EduHolg/IHP__SoC6169/SoC6169-main/netlist/schematic/SoC6169.spice

* ======================================================================
* SoC6169 - reference netlist for the KLayout LVS (IHP SG13CMOS5L)
* Generated by tools/gen_SoC6169_lvs.py
*  - IO: sg13cmos5l_io.cdl (PDK 456dd2d); sub! -> pin 'vsub' (= VSS at the top level)
*  - decaps: sg13cmos5l_stdcell.cdl
*  - core: COMPLETE_PROYECT_FIG_lvs.spice with the 11 ports added
* Cell count taken from the Magic SoC6169_magic.spice: COMPLETE_PROYECT_FIG=1, bondpad_70x70_5L=19, sg13cmos5l_Corner=4, sg13cmos5l_Filler1000=23, sg13cmos5l_Filler200=23, sg13cmos5l_Filler400=11, sg13cmos5l_Filler4000=28, sg13cmos5l_IOPadAnalog=1, sg13cmos5l_IOPadIOVdd=3, sg13cmos5l_IOPadIOVss=2, sg13cmos5l_IOPadIn=7, sg13cmos5l_IOPadOut30mA=1, sg13cmos5l_IOPadVdd=3, sg13cmos5l_IOPadVss=2, sg13cmos5l_decap_4=123, sg13cmos5l_decap_8=3577, sg13cmos5l_fill_1=123, sg13cmos5l_fill_2=104
* ======================================================================

.subckt SoC6169 IOVDD IOVSS VDD VSS analog_PAD clk_PAD input_PAD[0] input_PAD[1] input_PAD[2] input_PAD[3]
+ input_PAD[4] output_PAD rst_n_PAD

* ---- Core CAM 32x32 ----
Xi_chip_core en_write_core en_reference_core en_search_core reset_core clk_core serial_in_addr_core
+ output_core serial_in_data_core veval_in_core VDD VSS COMPLETE_PROYECT_FIG

* ---- Input pads (pad p2c vdd vss iovdd iovss sub) ----
Xinputs_0_pad input_PAD[0] en_write_core VDD VSS IOVDD IOVSS VSS sg13cmos5l_IOPadIn
Xinputs_1_pad input_PAD[1] en_reference_core VDD VSS IOVDD IOVSS VSS sg13cmos5l_IOPadIn
Xinputs_2_pad input_PAD[2] en_search_core VDD VSS IOVDD IOVSS VSS sg13cmos5l_IOPadIn
Xinputs_3_pad input_PAD[3] serial_in_addr_core VDD VSS IOVDD IOVSS VSS sg13cmos5l_IOPadIn
Xinputs_4_pad input_PAD[4] serial_in_data_core VDD VSS IOVDD IOVSS VSS sg13cmos5l_IOPadIn
Xrst_n_pad rst_n_PAD reset_core VDD VSS IOVDD IOVSS VSS sg13cmos5l_IOPadIn
Xclk_pad clk_PAD clk_core VDD VSS IOVDD IOVSS VSS sg13cmos5l_IOPadIn
* ---- Output pad (pad c2p vdd vss iovdd iovss sub) ----
Xoutputs_0_pad output_PAD output_core VDD VSS IOVDD IOVSS VSS sg13cmos5l_IOPadOut30mA
* ---- Analog pad VEVAL_IN (pad padres vdd vss iovdd iovss sub) ----
Xanalogs_0_pad analog_PAD veval_in_core VDD VSS IOVDD IOVSS VSS sg13cmos5l_IOPadAnalog
* ---- Power pads ----
Xvdd_pads_0 VDD VSS IOVDD IOVSS VSS sg13cmos5l_IOPadVdd
Xvdd_pads_1 VDD VSS IOVDD IOVSS VSS sg13cmos5l_IOPadVdd
Xvdd_pads_2 VDD VSS IOVDD IOVSS VSS sg13cmos5l_IOPadVdd
Xvss_pads_0 VDD VSS IOVDD IOVSS VSS sg13cmos5l_IOPadVss
Xvss_pads_1 VDD VSS IOVDD IOVSS VSS sg13cmos5l_IOPadVss
Xiovdd_pads_0 VDD VSS IOVDD IOVSS VSS sg13cmos5l_IOPadIOVdd
Xiovdd_pads_1 VDD VSS IOVDD IOVSS VSS sg13cmos5l_IOPadIOVdd
Xiovdd_pads_2 VDD VSS IOVDD IOVSS VSS sg13cmos5l_IOPadIOVdd
Xiovss_pads_0 VDD VSS IOVDD IOVSS VSS sg13cmos5l_IOPadIOVss
Xiovss_pads_1 VDD VSS IOVDD IOVSS VSS sg13cmos5l_IOPadIOVss
* ---- Pad-ring corners and fillers ----
XCorner_0 VDD VSS IOVDD IOVSS sg13cmos5l_Corner
XCorner_1 VDD VSS IOVDD IOVSS sg13cmos5l_Corner
XCorner_2 VDD VSS IOVDD IOVSS sg13cmos5l_Corner
XCorner_3 VDD VSS IOVDD IOVSS sg13cmos5l_Corner
XFiller4000_0 VDD VSS IOVDD IOVSS sg13cmos5l_Filler4000
XFiller4000_1 VDD VSS IOVDD IOVSS sg13cmos5l_Filler4000
XFiller4000_2 VDD VSS IOVDD IOVSS sg13cmos5l_Filler4000
XFiller4000_3 VDD VSS IOVDD IOVSS sg13cmos5l_Filler4000
XFiller4000_4 VDD VSS IOVDD IOVSS sg13cmos5l_Filler4000
XFiller4000_5 VDD VSS IOVDD IOVSS sg13cmos5l_Filler4000
XFiller4000_6 VDD VSS IOVDD IOVSS sg13cmos5l_Filler4000
XFiller4000_7 VDD VSS IOVDD IOVSS sg13cmos5l_Filler4000
XFiller4000_8 VDD VSS IOVDD IOVSS sg13cmos5l_Filler4000
XFiller4000_9 VDD VSS IOVDD IOVSS sg13cmos5l_Filler4000
XFiller4000_10 VDD VSS IOVDD IOVSS sg13cmos5l_Filler4000
XFiller4000_11 VDD VSS IOVDD IOVSS sg13cmos5l_Filler4000
XFiller4000_12 VDD VSS IOVDD IOVSS sg13cmos5l_Filler4000
XFiller4000_13 VDD VSS IOVDD IOVSS sg13cmos5l_Filler4000
XFiller4000_14 VDD VSS IOVDD IOVSS sg13cmos5l_Filler4000
XFiller4000_15 VDD VSS IOVDD IOVSS sg13cmos5l_Filler4000
XFiller4000_16 VDD VSS IOVDD IOVSS sg13cmos5l_Filler4000
XFiller4000_17 VDD VSS IOVDD IOVSS sg13cmos5l_Filler4000
XFiller4000_18 VDD VSS IOVDD IOVSS sg13cmos5l_Filler4000
XFiller4000_19 VDD VSS IOVDD IOVSS sg13cmos5l_Filler4000
XFiller4000_20 VDD VSS IOVDD IOVSS sg13cmos5l_Filler4000
XFiller4000_21 VDD VSS IOVDD IOVSS sg13cmos5l_Filler4000
XFiller4000_22 VDD VSS IOVDD IOVSS sg13cmos5l_Filler4000
XFiller4000_23 VDD VSS IOVDD IOVSS sg13cmos5l_Filler4000
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
Xdecap_8_546 VDD VSS sg13cmos5l_decap_8
Xdecap_8_547 VDD VSS sg13cmos5l_decap_8
Xdecap_8_548 VDD VSS sg13cmos5l_decap_8
Xdecap_8_549 VDD VSS sg13cmos5l_decap_8
Xdecap_8_550 VDD VSS sg13cmos5l_decap_8
Xdecap_8_551 VDD VSS sg13cmos5l_decap_8
Xdecap_8_552 VDD VSS sg13cmos5l_decap_8
Xdecap_8_553 VDD VSS sg13cmos5l_decap_8
Xdecap_8_554 VDD VSS sg13cmos5l_decap_8
Xdecap_8_555 VDD VSS sg13cmos5l_decap_8
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
