EduHolg/IHP__SoC6169/SoC6169-main/testbenches/spectre/digital_blocks.spice

simulator lang=spice
* Netlists of the 6 digital blocks (CAM_CONTROL, REFERENCE_MUX, decoder_5to32,
* shift_register_32, OUTPUT, SHIFT_5) with their sg13g2 standard cells.
* Taken from SoCXXXX-main/netlist/schematic/COMPLETE_PROYECT_FIG_lvs.spice (the netlist that passes LVS).
* Replaces the 6 includes CAMPROYECT/<block>/spiceText/spice.spc of the original testbench.

**************************************************
* SUBCKT: CAM_CONTROL
**************************************************

.subckt CAM_CONTROL EN_REFERENCE EN_SEARCH EN_WRITE PC VEVAL clk output_enable reset REF_SEL WL_REF
+ addr_shift_enable decoder_enable shift_enable VGND VPWR

Xctl_sg13g2_and2_1_3 ctl_sg13g2_and2_1_3_X VGND VPWR ctl_sg13g2_and2_1_3_B ctl_sg13g2_nor3_1_4_A
+ ctl_sg13g2_and2_1
Xctl_sg13g2_nand2b_1_0 VGND ctl_sg13g2_nor3_1_3_B ctl_sg13g2_nand2_1_4_A ctl_sg13g2_nor2_1_10_B VPWR
+ ctl_sg13g2_nand2b_1
Xctl_sg13g2_inv_1_1 ctl_sg13g2_inv_1_1_Y ctl_sg13g2_inv_1_6_A VGND VPWR ctl_sg13g2_inv_1
Xctl_sg13g2_buf_1_1 decoder_enable ctl_sg13g2_buf_1_1_A VGND VPWR ctl_sg13g2_buf_1
Xctl_sg13g2_dlygate4sd3_1_14 ctl_sg13g2_nor3_1_0_Y VPWR VGND ctl_sg13g2_nor4_1_0_A ctl_sg13g2_dlygate4sd3_1
Xctl_sg13g2_nor2_1_5 ctl_sg13g2_nor2_1_5_A VPWR ctl_sg13g2_nor4_1_0_D VGND ctl_sg13g2_nor3_1_0_A
+ ctl_sg13g2_nor2_1
Xctl_sg13g2_dfrbpq_1_9 clk VGND ctl_sg13g2_nor4_1_0_Y ctl_sg13g2_buf_1_5_A VPWR ctl_sg13g2_inv_1_17_Y
+ ctl_sg13g2_dfrbpq_1
Xctl_sg13g2_and2_1_4 ctl_sg13g2_nor3_1_0_B VGND VPWR ctl_sg13g2_or2_1_0_B ctl_sg13g2_or2_1_0_A
+ ctl_sg13g2_and2_1
Xctl_sg13g2_nand4_1_0 VPWR ctl_sg13g2_nand4_1_0_Y ctl_sg13g2_nor3_1_6_B ctl_sg13g2_nor2_1_2_A VGND
+ ctl_sg13g2_inv_1_0_A ctl_sg13g2_nor3_1_6_C ctl_sg13g2_nand4_1
Xctl_sg13g2_nand2b_1_1 VGND ctl_sg13g2_xor2_1_1_B ctl_sg13g2_nor2_1_10_B ctl_sg13g2_and2_1_2_B VPWR
+ ctl_sg13g2_nand2b_1
Xctl_sg13g2_inv_1_2 ctl_sg13g2_inv_1_2_Y ctl_sg13g2_inv_1_6_A VGND VPWR ctl_sg13g2_inv_1
Xctl_sg13g2_buf_1_2 VEVAL ctl_sg13g2_buf_1_2_A VGND VPWR ctl_sg13g2_buf_1
Xctl_sg13g2_buf_1_10 ctl_sg13g2_buf_1_10_X EN_WRITE VGND VPWR ctl_sg13g2_buf_1
Xctl_sg13g2_nor2_1_6 ctl_sg13g2_nor2_1_7_A VPWR ctl_sg13g2_nor2_1_6_Y VGND ctl_sg13g2_nor3_1_3_B
+ ctl_sg13g2_nor2_1
Xctl_sg13g2_dlygate4sd3_1_15 ctl_sg13g2_or2_1_0_A VPWR VGND ctl_sg13g2_xor2_1_0_A ctl_sg13g2_dlygate4sd3_1
Xctl_sg13g2_nand2b_1_2 VGND ctl_sg13g2_o21ai_1_7_A1 ctl_sg13g2_nand2_1_3_A ctl_sg13g2_buf_1_10_X VPWR
+ ctl_sg13g2_nand2b_1
Xctl_sg13g2_a221oi_1_0 ctl_sg13g2_and2_1_3_X ctl_sg13g2_o21ai_1_4_A2 ctl_sg13g2_nor3_1_1_B
+ ctl_sg13g2_nor3_1_2_A ctl_sg13g2_mux2_1_1_X VPWR ctl_sg13g2_inv_1_27_Y VGND ctl_sg13g2_a221oi_1
Xctl_sg13g2_buf_1_3 shift_enable ctl_sg13g2_buf_1_3_A VGND VPWR ctl_sg13g2_buf_1
Xctl_sg13g2_buf_1_11 REF_SEL ctl_sg13g2_buf_1_11_A VGND VPWR ctl_sg13g2_buf_1
Xctl_sg13g2_inv_1_3 ctl_sg13g2_inv_1_3_Y ctl_sg13g2_inv_1_6_A VGND VPWR ctl_sg13g2_inv_1
Xctl_sg13g2_a21o_1_0 ctl_sg13g2_nor3_1_6_C ctl_sg13g2_a21o_1_0_X VPWR VGND ctl_sg13g2_inv_1_0_A
+ ctl_sg13g2_nor3_1_6_B ctl_sg13g2_a21o_1
Xctl_sg13g2_nor2_1_7 ctl_sg13g2_nor2_1_7_A VPWR ctl_sg13g2_nor3_1_3_C VGND ctl_sg13g2_nor3_1_1_A
+ ctl_sg13g2_nor2_1
Xctl_sg13g2_nand2b_1_3 VGND ctl_sg13g2_a21oi_1_3_B1 ctl_sg13g2_nand2b_1_5_B ctl_sg13g2_buf_1_9_X VPWR
+ ctl_sg13g2_nand2b_1
Xctl_sg13g2_buf_1_4 output_enable ctl_sg13g2_buf_1_4_A VGND VPWR ctl_sg13g2_buf_1
Xctl_sg13g2_buf_1_12 ctl_sg13g2_buf_1_12_X EN_SEARCH VGND VPWR ctl_sg13g2_buf_1
Xctl_sg13g2_inv_1_4 ctl_sg13g2_inv_1_4_Y ctl_sg13g2_inv_1_4_A VGND VPWR ctl_sg13g2_inv_1
Xctl_sg13g2_a21o_1_1 ctl_sg13g2_nor2_1_9_Y ctl_sg13g2_a21o_1_1_X VPWR VGND ctl_sg13g2_a21o_1_1_A1
+ ctl_sg13g2_buf_1_12_X ctl_sg13g2_a21o_1
Xctl_sg13g2_nor2_1_8 ctl_sg13g2_nor2_1_9_Y VPWR ctl_sg13g2_inv_1_0_A VGND ctl_sg13g2_nor2_1_8_B
+ ctl_sg13g2_nor2_1
Xctl_sg13g2_nand2b_1_4 VGND ctl_sg13g2_a21o_1_1_A1 ctl_sg13g2_nand2b_1_4_Y ctl_sg13g2_buf_1_12_X VPWR
+ ctl_sg13g2_nand2b_1
Xctl_sg13g2_buf_1_5 addr_shift_enable ctl_sg13g2_buf_1_5_A VGND VPWR ctl_sg13g2_buf_1
Xctl_sg13g2_inv_1_5 ctl_sg13g2_inv_1_5_Y ctl_sg13g2_inv_1_6_A VGND VPWR ctl_sg13g2_inv_1
Xctl_sg13g2_buf_1_13 ctl_sg13g2_inv_1_6_A ctl_sg13g2_buf_1_8_A VGND VPWR ctl_sg13g2_buf_1
Xctl_sg13g2_a21o_1_2 ctl_sg13g2_nor3_1_0_B ctl_sg13g2_buf_1_15_A VPWR VGND ctl_sg13g2_or2_1_0_X
+ ctl_sg13g2_nor3_1_0_A ctl_sg13g2_a21o_1
Xctl_sg13g2_nor2_1_9 ctl_sg13g2_nor2_1_9_A VPWR ctl_sg13g2_nor2_1_9_Y VGND ctl_sg13g2_nor2_1_9_B
+ ctl_sg13g2_nor2_1
Xctl_sg13g2_nand2b_1_5 VGND ctl_sg13g2_nand2b_1_4_Y ctl_sg13g2_nor2_1_9_B ctl_sg13g2_nand2b_1_5_B VPWR
+ ctl_sg13g2_nand2b_1
Xctl_sg13g2_buf_1_6 ctl_sg13g2_buf_1_7_A reset VGND VPWR ctl_sg13g2_buf_1
Xctl_sg13g2_inv_1_6 ctl_sg13g2_inv_1_6_Y ctl_sg13g2_inv_1_6_A VGND VPWR ctl_sg13g2_inv_1
Xctl_sg13g2_buf_1_14 ctl_sg13g2_xor2_1_1_A ctl_sg13g2_buf_1_14_A VGND VPWR ctl_sg13g2_buf_1
Xctl_sg13g2_a21o_1_3 ctl_sg13g2_and2_1_3_X ctl_sg13g2_or2_1_0_B VPWR VGND ctl_sg13g2_inv_1_27_Y
+ ctl_sg13g2_mux2_1_1_X ctl_sg13g2_a21o_1
Xctl_sg13g2_nand2b_1_6 VGND ctl_sg13g2_xor2_1_1_A ctl_sg13g2_mux2_1_1_A0 ctl_sg13g2_xor2_1_1_B VPWR
+ ctl_sg13g2_nand2b_1
Xctl_sg13g2_buf_1_7 ctl_sg13g2_buf_1_8_A ctl_sg13g2_buf_1_7_A VGND VPWR ctl_sg13g2_buf_1
Xctl_sg13g2_inv_1_7 ctl_sg13g2_inv_1_7_Y ctl_sg13g2_inv_1_9_A VGND VPWR ctl_sg13g2_inv_1
Xctl_sg13g2_buf_1_15 ctl_sg13g2_nor3_1_3_B ctl_sg13g2_buf_1_15_A VGND VPWR ctl_sg13g2_buf_1
Xctl_sg13g2_buf_1_8 ctl_sg13g2_inv_1_9_A ctl_sg13g2_buf_1_8_A VGND VPWR ctl_sg13g2_buf_1
Xctl_sg13g2_buf_1_16 WL_REF ctl_sg13g2_buf_1_16_A VGND VPWR ctl_sg13g2_buf_1
Xctl_sg13g2_inv_1_8 ctl_sg13g2_inv_1_8_Y ctl_sg13g2_inv_1_9_A VGND VPWR ctl_sg13g2_inv_1
Xctl_sg13g2_dlygate4sd3_1_0 ctl_sg13g2_a21oi_1_1_Y VPWR VGND ctl_sg13g2_nor3_1_6_C ctl_sg13g2_dlygate4sd3_1
Xctl_sg13g2_o21ai_1_0 VGND VPWR ctl_sg13g2_o21ai_1_0_Y ctl_sg13g2_buf_1_15_A ctl_sg13g2_buf_1_14_A
+ ctl_sg13g2_nor3_1_4_A ctl_sg13g2_o21ai_1
Xctl_sg13g2_buf_1_9 ctl_sg13g2_buf_1_9_X EN_REFERENCE VGND VPWR ctl_sg13g2_buf_1
Xctl_sg13g2_inv_1_9 ctl_sg13g2_inv_1_9_Y ctl_sg13g2_inv_1_9_A VGND VPWR ctl_sg13g2_inv_1
Xctl_sg13g2_nor2_1_10 ctl_sg13g2_nor3_1_4_Y VPWR ctl_sg13g2_nor2_1_10_Y VGND ctl_sg13g2_nor2_1_10_B
+ ctl_sg13g2_nor2_1
Xctl_sg13g2_dlygate4sd3_1_1 ctl_sg13g2_nor3_1_4_A VPWR VGND ctl_sg13g2_o21ai_1_6_A1 ctl_sg13g2_dlygate4sd3_1
Xctl_sg13g2_o21ai_1_1 VGND VPWR ctl_sg13g2_o21ai_1_1_Y ctl_sg13g2_nor2_1_2_A ctl_sg13g2_nor3_1_5_C
+ ctl_sg13g2_nor3_1_6_C ctl_sg13g2_o21ai_1
Xctl_sg13g2_nor4_1_0 VGND VPWR ctl_sg13g2_nor4_1_0_B ctl_sg13g2_nor4_1_0_C ctl_sg13g2_nor4_1_0_Y
+ ctl_sg13g2_nor4_1_0_A ctl_sg13g2_nor4_1_0_D ctl_sg13g2_nor4_1
Xctl_sg13g2_dlygate4sd3_1_2 ctl_sg13g2_nor3_1_4_B VPWR VGND ctl_sg13g2_a21oi_1_1_A1 ctl_sg13g2_dlygate4sd3_1
Xctl_sg13g2_o21ai_1_2 VGND VPWR ctl_sg13g2_o21ai_1_2_Y ctl_sg13g2_and2_1_3_B ctl_sg13g2_inv_1_25_Y
+ ctl_sg13g2_inv_1_27_Y ctl_sg13g2_o21ai_1
Xctl_sg13g2_dlygate4sd3_1_3 ctl_sg13g2_nand4_1_0_Y VPWR VGND ctl_sg13g2_nor4_1_0_C ctl_sg13g2_dlygate4sd3_1
Xctl_sg13g2_o21ai_1_3 VGND VPWR ctl_sg13g2_o21ai_1_3_Y ctl_sg13g2_nor4_1_0_C ctl_sg13g2_a21o_1_0_X
+ ctl_sg13g2_nor2_1_1_Y ctl_sg13g2_o21ai_1
Xctl_sg13g2_dlygate4sd3_1_4 ctl_sg13g2_dfrbpq_1_17_Q VPWR VGND ctl_sg13g2_nor3_1_1_A ctl_sg13g2_dlygate4sd3_1
Xctl_sg13g2_o21ai_1_4 VGND VPWR ctl_sg13g2_nor3_1_0_A ctl_sg13g2_a21oi_1_2_Y ctl_sg13g2_o21ai_1_4_A2
+ ctl_sg13g2_nor3_1_1_Y ctl_sg13g2_o21ai_1
Xctl_sg13g2_dlygate4sd3_1_5 ctl_sg13g2_dfrbpq_1_8_Q VPWR VGND ctl_sg13g2_nor3_1_1_B ctl_sg13g2_dlygate4sd3_1
Xctl_sg13g2_o21ai_1_5 VGND VPWR ctl_sg13g2_and2_1_2_B ctl_sg13g2_nor3_1_4_B ctl_sg13g2_xor2_1_1_A
+ ctl_sg13g2_nor3_1_4_A ctl_sg13g2_o21ai_1
Xctl_sg13g2_dlygate4sd3_1_6 ctl_sg13g2_dfrbpq_1_11_Q VPWR VGND ctl_sg13g2_nor2_1_7_A ctl_sg13g2_dlygate4sd3_1
Xctl_sg13g2_o21ai_1_6 VGND VPWR ctl_sg13g2_nor2_1_2_A ctl_sg13g2_nand2_1_5_Y ctl_sg13g2_and3_1_1_X
+ ctl_sg13g2_o21ai_1_6_A1 ctl_sg13g2_o21ai_1
Xctl_sg13g2_decap_8_0 VPWR VGND ctl_sg13g2_decap_8
Xctl_sg13g2_or2_1_0 ctl_sg13g2_or2_1_0_A VGND ctl_sg13g2_or2_1_0_B ctl_sg13g2_or2_1_0_X VPWR ctl_sg13g2_or2_1
Xctl_sg13g2_dlygate4sd3_1_7 ctl_sg13g2_dfrbpq_1_10_Q VPWR VGND ctl_sg13g2_nor3_1_1_C ctl_sg13g2_dlygate4sd3_1
Xctl_sg13g2_o21ai_1_7 VGND VPWR ctl_sg13g2_o21ai_1_7_Y ctl_sg13g2_buf_1_10_X ctl_sg13g2_nor2b_1_0_Y
+ ctl_sg13g2_o21ai_1_7_A1 ctl_sg13g2_o21ai_1
Xctl_sg13g2_decap_8_1 VPWR VGND ctl_sg13g2_decap_8
Xctl_sg13g2_dlygate4sd3_1_8 ctl_sg13g2_dfrbpq_1_16_Q VPWR VGND ctl_sg13g2_o21ai_1_7_A1
+ ctl_sg13g2_dlygate4sd3_1
Xctl_sg13g2_a22oi_1_0 ctl_sg13g2_nand2_1_4_B ctl_sg13g2_nor2_1_10_Y VPWR ctl_sg13g2_nand2_1_3_Y
+ ctl_sg13g2_nor3_1_3_B VGND ctl_sg13g2_nor2b_1_0_Y ctl_sg13g2_a22oi_1
Xctl_sg13g2_decap_8_2 VPWR VGND ctl_sg13g2_decap_8
Xctl_sg13g2_dlygate4sd3_1_9 ctl_sg13g2_a21oi_1_3_Y VPWR VGND ctl_sg13g2_nor2b_1_1_A ctl_sg13g2_dlygate4sd3_1
Xctl_sg13g2_decap_8_3 VPWR VGND ctl_sg13g2_decap_8
Xctl_sg13g2_a21oi_1_0 VPWR VGND ctl_sg13g2_nor3_1_6_B ctl_sg13g2_inv_1_0_A ctl_sg13g2_nor2_1_2_A
+ ctl_sg13g2_a21oi_1_0_Y ctl_sg13g2_a21oi_1
Xctl_sg13g2_decap_8_4 VPWR VGND ctl_sg13g2_decap_8
Xctl_sg13g2_a21oi_1_1 VPWR VGND ctl_sg13g2_o21ai_1_0_Y ctl_sg13g2_a21oi_1_1_A1 ctl_sg13g2_a21oi_1_4_Y
+ ctl_sg13g2_a21oi_1_1_Y ctl_sg13g2_a21oi_1
Xctl_sg13g2_decap_8_5 VPWR VGND ctl_sg13g2_decap_8
Xctl_sg13g2_a21oi_1_2 VPWR VGND ctl_sg13g2_mux2_1_1_X ctl_sg13g2_inv_1_27_Y ctl_sg13g2_a21oi_1_5_Y
+ ctl_sg13g2_a21oi_1_2_Y ctl_sg13g2_a21oi_1
Xctl_sg13g2_a21oi_1_3 VPWR VGND ctl_sg13g2_nand2_1_3_A ctl_sg13g2_nor2b_1_0_Y ctl_sg13g2_a21oi_1_3_B1
+ ctl_sg13g2_a21oi_1_3_Y ctl_sg13g2_a21oi_1
Xctl_sg13g2_decap_4_0 VPWR VGND ctl_sg13g2_decap_4
Xctl_sg13g2_nor3_1_0 ctl_sg13g2_nor3_1_0_A ctl_sg13g2_nor3_1_0_Y ctl_sg13g2_nor3_1_0_B ctl_sg13g2_nor3_1_0_C
+ VPWR VGND ctl_sg13g2_nor3_1
Xctl_sg13g2_inv_1_20 ctl_sg13g2_inv_1_20_Y ctl_sg13g2_buf_1_8_A VGND VPWR ctl_sg13g2_inv_1
Xctl_sg13g2_a21oi_1_4 VPWR VGND ctl_sg13g2_nand2b_1_5_B ctl_sg13g2_nand2b_1_4_Y ctl_sg13g2_nor2_1_9_A
+ ctl_sg13g2_a21oi_1_4_Y ctl_sg13g2_a21oi_1
Xctl_sg13g2_nor3_1_1 ctl_sg13g2_nor3_1_1_A ctl_sg13g2_nor3_1_1_Y ctl_sg13g2_nor3_1_1_B ctl_sg13g2_nor3_1_1_C
+ VPWR VGND ctl_sg13g2_nor3_1
Xctl_sg13g2_decap_4_1 VPWR VGND ctl_sg13g2_decap_4
Xctl_sg13g2_inv_1_21 ctl_sg13g2_inv_1_21_Y ctl_sg13g2_inv_1_9_A VGND VPWR ctl_sg13g2_inv_1
Xctl_sg13g2_inv_1_10 ctl_sg13g2_inv_1_10_Y ctl_sg13g2_inv_1_9_A VGND VPWR ctl_sg13g2_inv_1
Xctl_sg13g2_and3_1_0 ctl_sg13g2_and3_1_0_X ctl_sg13g2_nor3_1_6_B VPWR VGND ctl_sg13g2_nor3_1_5_A
+ ctl_sg13g2_inv_1_0_A ctl_sg13g2_and3_1
Xctl_sg13g2_a21oi_1_5 VPWR VGND ctl_sg13g2_xor2_1_1_A ctl_sg13g2_inv_1_25_Y ctl_sg13g2_inv_1_27_Y
+ ctl_sg13g2_a21oi_1_5_Y ctl_sg13g2_a21oi_1
Xctl_sg13g2_decap_4_2 VPWR VGND ctl_sg13g2_decap_4
Xctl_sg13g2_nor3_1_2 ctl_sg13g2_nor3_1_2_A ctl_sg13g2_nor3_1_2_Y ctl_sg13g2_nor3_1_3_B ctl_sg13g2_nor3_1_2_C
+ VPWR VGND ctl_sg13g2_nor3_1
Xctl_sg13g2_inv_1_22 ctl_sg13g2_inv_1_22_Y ctl_sg13g2_inv_1_6_A VGND VPWR ctl_sg13g2_inv_1
Xctl_sg13g2_inv_1_11 ctl_sg13g2_nor3_1_5_B ctl_sg13g2_nor3_1_6_C VGND VPWR ctl_sg13g2_inv_1
Xctl_sg13g2_mux2_1_0 ctl_sg13g2_and2_1_2_X ctl_sg13g2_nor2_1_8_B ctl_sg13g2_nor3_1_3_B VPWR VGND
+ ctl_sg13g2_xor2_1_1_A ctl_sg13g2_mux2_1
Xctl_sg13g2_and3_1_1 ctl_sg13g2_and3_1_1_X ctl_sg13g2_xor2_1_1_B VPWR VGND ctl_sg13g2_buf_1_15_A
+ ctl_sg13g2_xor2_1_1_A ctl_sg13g2_and3_1
Xctl_sg13g2_nand2_1_0 ctl_sg13g2_nor3_1_5_C VPWR ctl_sg13g2_inv_1_0_Y VGND ctl_sg13g2_nor3_1_6_B
+ ctl_sg13g2_nand2_1
Xctl_sg13g2_nor3_1_3 ctl_sg13g2_nor3_1_3_A ctl_sg13g2_nor3_1_3_Y ctl_sg13g2_nor3_1_3_B ctl_sg13g2_nor3_1_3_C
+ VPWR VGND ctl_sg13g2_nor3_1
Xctl_sg13g2_decap_4_3 VPWR VGND ctl_sg13g2_decap_4
Xctl_sg13g2_inv_1_23 ctl_sg13g2_inv_1_23_Y ctl_sg13g2_inv_1_6_A VGND VPWR ctl_sg13g2_inv_1
Xctl_sg13g2_inv_1_12 ctl_sg13g2_nor3_1_5_A ctl_sg13g2_nor2_1_2_A VGND VPWR ctl_sg13g2_inv_1
Xctl_sg13g2_mux2_1_1 ctl_sg13g2_xor2_1_1_X ctl_sg13g2_mux2_1_1_X ctl_sg13g2_nor3_1_4_B VPWR VGND
+ ctl_sg13g2_mux2_1_1_A0 ctl_sg13g2_mux2_1
Xctl_sg13g2_xor2_1_0 ctl_sg13g2_xor2_1_0_X VPWR ctl_sg13g2_xor2_1_0_B ctl_sg13g2_xor2_1_0_A VGND
+ ctl_sg13g2_xor2_1
Xctl_sg13g2_dfrbpq_1_10 clk VGND ctl_sg13g2_nor3_1_2_Y ctl_sg13g2_dfrbpq_1_10_Q VPWR ctl_sg13g2_inv_1_14_Y
+ ctl_sg13g2_dfrbpq_1
Xctl_sg13g2_nand2_1_1 ctl_sg13g2_xor2_1_0_B VPWR ctl_sg13g2_nor3_1_1_B VGND ctl_sg13g2_nor3_1_2_A
+ ctl_sg13g2_nand2_1
Xctl_sg13g2_nor3_1_4 ctl_sg13g2_nor3_1_4_A ctl_sg13g2_nor3_1_4_Y ctl_sg13g2_nor3_1_4_B ctl_sg13g2_xor2_1_1_A
+ VPWR VGND ctl_sg13g2_nor3_1
Xctl_sg13g2_inv_1_24 ctl_sg13g2_inv_1_24_Y ctl_sg13g2_inv_1_6_A VGND VPWR ctl_sg13g2_inv_1
Xctl_sg13g2_inv_1_13 ctl_sg13g2_inv_1_13_Y ctl_sg13g2_inv_1_9_A VGND VPWR ctl_sg13g2_inv_1
Xctl_sg13g2_xor2_1_1 ctl_sg13g2_xor2_1_1_X VPWR ctl_sg13g2_xor2_1_1_B ctl_sg13g2_xor2_1_1_A VGND
+ ctl_sg13g2_xor2_1
Xctl_sg13g2_dfrbpq_1_11 clk VGND ctl_sg13g2_nor2_1_6_Y ctl_sg13g2_dfrbpq_1_11_Q VPWR ctl_sg13g2_inv_1_18_Y
+ ctl_sg13g2_dfrbpq_1
Xctl_sg13g2_nor2b_1_0 ctl_sg13g2_xor2_1_1_B ctl_sg13g2_nor3_1_4_Y VPWR ctl_sg13g2_nor2b_1_0_Y VGND
+ ctl_sg13g2_nor2b_1
Xctl_sg13g2_nand2_1_2 ctl_sg13g2_nor2_1_9_A VPWR ctl_sg13g2_nor2b_1_0_Y VGND ctl_sg13g2_nand2_1_3_A
+ ctl_sg13g2_nand2_1
Xctl_sg13g2_nand3b_1_0 ctl_sg13g2_nor3_1_4_B ctl_sg13g2_and2_1_3_B VPWR VGND ctl_sg13g2_xor2_1_1_A
+ ctl_sg13g2_xor2_1_1_B ctl_sg13g2_nand3b_1
Xctl_sg13g2_nor3_1_5 ctl_sg13g2_nor3_1_5_A ctl_sg13g2_nor3_1_5_Y ctl_sg13g2_nor3_1_5_B ctl_sg13g2_nor3_1_5_C
+ VPWR VGND ctl_sg13g2_nor3_1
Xctl_sg13g2_inv_1_14 ctl_sg13g2_inv_1_14_Y ctl_sg13g2_inv_1_9_A VGND VPWR ctl_sg13g2_inv_1
Xctl_sg13g2_inv_1_25 ctl_sg13g2_inv_1_25_Y ctl_sg13g2_nor3_1_4_B VGND VPWR ctl_sg13g2_inv_1
Xctl_sg13g2_dfrbpq_1_12 clk VGND ctl_sg13g2_o21ai_1_1_Y ctl_sg13g2_buf_1_11_A VPWR ctl_sg13g2_inv_1_28_Y
+ ctl_sg13g2_dfrbpq_1
Xctl_sg13g2_nor2b_1_1 ctl_sg13g2_nor2b_1_1_A ctl_sg13g2_buf_1_9_X VPWR ctl_sg13g2_nor2b_1_1_Y VGND
+ ctl_sg13g2_nor2b_1
Xctl_sg13g2_nand2_1_3 ctl_sg13g2_nand2_1_3_Y VPWR ctl_sg13g2_nand2_1_3_A VGND ctl_sg13g2_nor2_1_9_B
+ ctl_sg13g2_nand2_1
Xctl_sg13g2_nor3_1_6 ctl_sg13g2_inv_1_0_A ctl_sg13g2_nor3_1_6_Y ctl_sg13g2_nor3_1_6_B ctl_sg13g2_nor3_1_6_C
+ VPWR VGND ctl_sg13g2_nor3_1
Xctl_sg13g2_inv_1_15 ctl_sg13g2_nor2_1_5_A ctl_sg13g2_nor3_1_1_C VGND VPWR ctl_sg13g2_inv_1
Xctl_sg13g2_inv_1_26 ctl_sg13g2_buf_1_2_A ctl_sg13g2_inv_1_26_A VGND VPWR ctl_sg13g2_inv_1
Xctl_sg13g2_dfrbpq_1_13 clk VGND ctl_sg13g2_nor3_1_6_Y ctl_sg13g2_buf_1_16_A VPWR ctl_sg13g2_inv_1_24_Y
+ ctl_sg13g2_dfrbpq_1
Xctl_sg13g2_nand2_1_4 ctl_sg13g2_nor3_1_6_B VPWR ctl_sg13g2_nand2_1_4_A VGND ctl_sg13g2_nand2_1_4_B
+ ctl_sg13g2_nand2_1
Xctl_sg13g2_inv_1_27 ctl_sg13g2_inv_1_27_Y ctl_sg13g2_nor3_1_4_A VGND VPWR ctl_sg13g2_inv_1
Xctl_sg13g2_inv_1_16 ctl_sg13g2_inv_1_16_Y ctl_sg13g2_buf_1_8_A VGND VPWR ctl_sg13g2_inv_1
Xctl_sg13g2_dfrbpq_1_0 clk VGND ctl_sg13g2_nor3_1_5_Y ctl_sg13g2_buf_1_1_A VPWR ctl_sg13g2_inv_1_1_Y
+ ctl_sg13g2_dfrbpq_1
Xctl_sg13g2_dfrbpq_1_14 clk VGND ctl_sg13g2_dfrbpq_1_14_D ctl_sg13g2_dfrbpq_1_14_Q VPWR ctl_sg13g2_inv_1_23_Y
+ ctl_sg13g2_dfrbpq_1
Xctl_sg13g2_nand2_1_5 ctl_sg13g2_nand2_1_5_Y VPWR ctl_sg13g2_nor3_1_3_B VGND ctl_sg13g2_o21ai_1_2_Y
+ ctl_sg13g2_nand2_1
Xctl_sg13g2_inv_1_17 ctl_sg13g2_inv_1_17_Y ctl_sg13g2_buf_1_8_A VGND VPWR ctl_sg13g2_inv_1
Xctl_sg13g2_inv_1_28 ctl_sg13g2_inv_1_28_Y ctl_sg13g2_buf_1_8_A VGND VPWR ctl_sg13g2_inv_1
Xctl_sg13g2_dfrbpq_1_1 clk VGND ctl_sg13g2_inv_1_0_Y ctl_sg13g2_buf_1_14_A VPWR ctl_sg13g2_inv_1_6_Y
+ ctl_sg13g2_dfrbpq_1
Xctl_sg13g2_dfrbpq_1_15 clk VGND ctl_sg13g2_nor2b_1_1_Y ctl_sg13g2_dfrbpq_1_15_Q VPWR ctl_sg13g2_inv_1_22_Y
+ ctl_sg13g2_dfrbpq_1
Xctl_sg13g2_inv_1_18 ctl_sg13g2_inv_1_18_Y ctl_sg13g2_inv_1_9_A VGND VPWR ctl_sg13g2_inv_1
Xctl_sg13g2_dfrbpq_1_2 clk VGND ctl_sg13g2_nor3_1_6_B ctl_sg13g2_xor2_1_1_B VPWR ctl_sg13g2_inv_1_5_Y
+ ctl_sg13g2_dfrbpq_1
Xctl_sg13g2_dfrbpq_1_16 clk VGND ctl_sg13g2_inv_1_19_Y ctl_sg13g2_dfrbpq_1_16_Q VPWR ctl_sg13g2_inv_1_20_Y
+ ctl_sg13g2_dfrbpq_1
Xctl_sg13g2_inv_1_19 ctl_sg13g2_inv_1_19_Y ctl_sg13g2_inv_1_19_A VGND VPWR ctl_sg13g2_inv_1
Xctl_sg13g2_dfrbpq_1_3 clk VGND ctl_sg13g2_a21oi_1_0_Y ctl_sg13g2_inv_1_26_A VPWR ctl_sg13g2_inv_1_3_Y
+ ctl_sg13g2_dfrbpq_1
Xctl_sg13g2_dfrbpq_1_17 clk VGND ctl_sg13g2_nor3_1_3_Y ctl_sg13g2_dfrbpq_1_17_Q VPWR ctl_sg13g2_inv_1_21_Y
+ ctl_sg13g2_dfrbpq_1
Xctl_sg13g2_nor2_1_0 ctl_sg13g2_nor3_1_3_B VPWR ctl_sg13g2_nor4_1_0_B VGND ctl_sg13g2_xor2_1_0_X
+ ctl_sg13g2_nor2_1
Xctl_sg13g2_dfrbpq_1_4 clk VGND ctl_sg13g2_nor3_1_5_B ctl_sg13g2_nor3_1_4_B VPWR ctl_sg13g2_inv_1_2_Y
+ ctl_sg13g2_dfrbpq_1
Xctl_sg13g2_dfrbpq_1_18 clk VGND ctl_sg13g2_and3_1_0_X ctl_sg13g2_inv_1_4_A VPWR ctl_sg13g2_inv_1_7_Y
+ ctl_sg13g2_dfrbpq_1
Xctl_sg13g2_dlygate4sd3_1_10 ctl_sg13g2_dfrbpq_1_15_Q VPWR VGND ctl_sg13g2_a21oi_1_3_B1
+ ctl_sg13g2_dlygate4sd3_1
Xctl_sg13g2_nor2_1_1 ctl_sg13g2_inv_1_0_A VPWR ctl_sg13g2_nor2_1_1_Y VGND ctl_sg13g2_nor3_1_6_B
+ ctl_sg13g2_nor2_1
Xctl_sg13g2_dfrbpq_1_5 clk VGND ctl_sg13g2_nor2_1_2_Y ctl_sg13g2_buf_1_4_A VPWR ctl_sg13g2_inv_1_8_Y
+ ctl_sg13g2_dfrbpq_1
Xctl_sg13g2_and2_1_0 ctl_sg13g2_nor3_1_2_A VGND VPWR ctl_sg13g2_nor3_1_3_A ctl_sg13g2_nor3_1_1_C
+ ctl_sg13g2_and2_1
Xctl_sg13g2_dfrbpq_1_19 clk VGND ctl_sg13g2_nor3_1_5_A ctl_sg13g2_nor3_1_4_A VPWR ctl_sg13g2_inv_1_10_Y
+ ctl_sg13g2_dfrbpq_1
Xctl_sg13g2_dlygate4sd3_1_11 ctl_sg13g2_a21o_1_1_X VPWR VGND ctl_sg13g2_dfrbpq_1_14_D ctl_sg13g2_dlygate4sd3_1
Xctl_sg13g2_nor2_1_2 ctl_sg13g2_nor2_1_2_A VPWR ctl_sg13g2_nor2_1_2_Y VGND ctl_sg13g2_nor3_1_5_C
+ ctl_sg13g2_nor2_1
Xctl_sg13g2_dfrbpq_1_6 clk VGND ctl_sg13g2_nor4_1_0_B ctl_sg13g2_or2_1_0_A VPWR ctl_sg13g2_inv_1_9_Y
+ ctl_sg13g2_dfrbpq_1
Xctl_sg13g2_and2_1_1 ctl_sg13g2_nor3_1_3_A VGND VPWR ctl_sg13g2_nor3_1_1_A ctl_sg13g2_nor2_1_7_A
+ ctl_sg13g2_and2_1
Xctl_sg13g2_dlygate4sd3_1_12 ctl_sg13g2_dfrbpq_1_14_Q VPWR VGND ctl_sg13g2_a21o_1_1_A1
+ ctl_sg13g2_dlygate4sd3_1
Xctl_sg13g2_nor2_1_3 ctl_sg13g2_nor3_1_1_B VPWR ctl_sg13g2_nor3_1_0_C VGND ctl_sg13g2_nor3_1_2_A
+ ctl_sg13g2_nor2_1
Xctl_sg13g2_dfrbpq_1_7 clk VGND ctl_sg13g2_o21ai_1_3_Y ctl_sg13g2_buf_1_3_A VPWR ctl_sg13g2_inv_1_13_Y
+ ctl_sg13g2_dfrbpq_1
Xctl_sg13g2_and2_1_2 ctl_sg13g2_and2_1_2_X VGND VPWR ctl_sg13g2_and2_1_2_B ctl_sg13g2_xor2_1_1_X
+ ctl_sg13g2_and2_1
Xctl_sg13g2_buf_1_0 PC ctl_sg13g2_inv_1_4_Y VGND VPWR ctl_sg13g2_buf_1
Xctl_sg13g2_inv_1_0 ctl_sg13g2_inv_1_0_Y ctl_sg13g2_inv_1_0_A VGND VPWR ctl_sg13g2_inv_1
Xctl_sg13g2_dlygate4sd3_1_13 ctl_sg13g2_o21ai_1_7_Y VPWR VGND ctl_sg13g2_inv_1_19_A ctl_sg13g2_dlygate4sd3_1
Xctl_sg13g2_nor2_1_4 ctl_sg13g2_nor3_1_1_C VPWR ctl_sg13g2_nor3_1_2_C VGND ctl_sg13g2_nor3_1_3_A
+ ctl_sg13g2_nor2_1
Xctl_sg13g2_dfrbpq_1_8 clk VGND ctl_sg13g2_nor4_1_0_A ctl_sg13g2_dfrbpq_1_8_Q VPWR ctl_sg13g2_inv_1_16_Y
+ ctl_sg13g2_dfrbpq_1

.ends CAM_CONTROL


**************************************************
* SUBCKT: ctl_sg13g2_and2_1
**************************************************

.subckt ctl_sg13g2_and2_1 X VSS VDD B A

MP0 X a_45_160 VDD VDD sg13_lv_pmos w=1120n l=130n ng=1 m=1
MN1 X a_45_160 VSS VSS sg13_lv_nmos w=740n l=130n ng=1 m=1
MP2 a_45_160 A VDD VDD sg13_lv_pmos w=840n l=130n ng=1 m=1
MP3 VDD B a_45_160 VDD sg13_lv_pmos w=840n l=130n ng=1 m=1
MN4 a_139_160 A a_45_160 VSS sg13_lv_nmos w=640n l=130n ng=1 m=1
MN5 VSS B a_139_160 VSS sg13_lv_nmos w=640n l=130n ng=1 m=1

.ends ctl_sg13g2_and2_1


**************************************************
* SUBCKT: ctl_sg13g2_nand2b_1
**************************************************

.subckt ctl_sg13g2_nand2b_1 VSS A_N Y B VDD

MP0 VDD A_N a_27_156 VDD sg13_lv_pmos w=840n l=130n ng=1 m=1
MP1 Y B VDD VDD sg13_lv_pmos w=1120n l=130n ng=1 m=1
MN2 Y a_27_156 a_229_118 VSS sg13_lv_nmos w=740n l=130n ng=1 m=1
MN3 VSS A_N a_27_156 VSS sg13_lv_nmos w=550n l=130n ng=1 m=1
MP4 VDD a_27_156 Y VDD sg13_lv_pmos w=1120n l=130n ng=1 m=1
MN5 a_229_118 B VSS VSS sg13_lv_nmos w=740n l=130n ng=1 m=1

.ends ctl_sg13g2_nand2b_1


**************************************************
* SUBCKT: ctl_sg13g2_inv_1
**************************************************

.subckt ctl_sg13g2_inv_1 Y A VSS VDD

MP0 Y A VDD VDD sg13_lv_pmos w=1120n l=130n ng=1 m=1
MN1 Y A VSS VSS sg13_lv_nmos w=740n l=130n ng=1 m=1

.ends ctl_sg13g2_inv_1


**************************************************
* SUBCKT: ctl_sg13g2_buf_1
**************************************************

.subckt ctl_sg13g2_buf_1 X A VSS VDD

MN0 X a_40_152 VSS VSS sg13_lv_nmos w=740n l=130n ng=1 m=1
MP1 X a_40_152 VDD VDD sg13_lv_pmos w=1120n l=130n ng=1 m=1
MP2 VDD A a_40_152 VDD sg13_lv_pmos w=840n l=130n ng=1 m=1
MN3 VSS A a_40_152 VSS sg13_lv_nmos w=550n l=130n ng=1 m=1

.ends ctl_sg13g2_buf_1


**************************************************
* SUBCKT: ctl_sg13g2_dlygate4sd3_1
**************************************************

.subckt ctl_sg13g2_dlygate4sd3_1 A VDD VSS X

MP0 VDD A a_56_118 VDD sg13_lv_pmos w=420n l=130n ng=1 m=1
MN1 VSS a_326_118 a_438_182 VSS sg13_lv_nmos w=420n l=500n ng=1 m=1
MP2 VDD a_326_118 a_438_182 VDD sg13_lv_pmos w=1u l=500n ng=1 m=1
MP3 X a_438_182 VDD VDD sg13_lv_pmos w=1120n l=130n ng=1 m=1
MP4 a_326_118 a_56_118 VDD VDD sg13_lv_pmos w=1u l=500n ng=1 m=1
MN5 VSS A a_56_118 VSS sg13_lv_nmos w=420n l=130n ng=1 m=1
MN6 X a_438_182 VSS VSS sg13_lv_nmos w=740n l=130n ng=1 m=1
MN7 a_326_118 a_56_118 VSS VSS sg13_lv_nmos w=420n l=500n ng=1 m=1

.ends ctl_sg13g2_dlygate4sd3_1


**************************************************
* SUBCKT: ctl_sg13g2_nor2_1
**************************************************

.subckt ctl_sg13g2_nor2_1 A VDD Y VSS B

MN0 Y A VSS VSS sg13_lv_nmos w=740n l=130n ng=1 m=1
MP1 a_170_412 A VDD VDD sg13_lv_pmos w=1120n l=130n ng=1 m=1
MN2 VSS B Y VSS sg13_lv_nmos w=740n l=130n ng=1 m=1
MP3 Y B a_170_412 VDD sg13_lv_pmos w=1120n l=130n ng=1 m=1

.ends ctl_sg13g2_nor2_1


**************************************************
* SUBCKT: ctl_sg13g2_dfrbpq_1
**************************************************

.subckt ctl_sg13g2_dfrbpq_1 CLK VSS D Q VDD RESET_B

MP0 VDD RESET_B a_298_337 VDD sg13_lv_pmos w=420n l=130n ng=1 m=1
MN1 VSS RESET_B a_132_114 VSS sg13_lv_nmos w=420n l=130n ng=1 m=1
MN2 a_550_127 RESET_B VSS VSS sg13_lv_nmos w=420n l=130n ng=1 m=1
MP3 a_298_337 a_741_93 a_681_505 VDD sg13_lv_pmos w=420n l=130n ng=1 m=1
MN4 a_1840_334 a_1583_191 a_2002_114 VSS sg13_lv_nmos w=420n l=130n ng=1 m=1
MP5 a_38_114 a_843_236 a_298_337 VDD sg13_lv_pmos w=420n l=130n ng=1 m=1
MN6 a_741_93 CLK VSS VSS sg13_lv_nmos w=740n l=130n ng=1 m=1
MP7 a_38_114 D VDD VDD sg13_lv_pmos w=420n l=130n ng=1 m=1
MP8 a_741_93 CLK VDD VDD sg13_lv_pmos w=1120n l=130n ng=1 m=1
MN9 VSS a_741_93 a_843_236 VSS sg13_lv_nmos w=740n l=130n ng=1 m=1
MN10 VSS a_1840_334 a_1489_191 VSS sg13_lv_nmos w=420n l=130n ng=1 m=1
MP11 VDD RESET_B a_38_114 VDD sg13_lv_pmos w=420n l=130n ng=1 m=1
MN12 a_324_432 a_298_337 VSS VSS sg13_lv_nmos w=740n l=130n ng=1 m=1
MP13 VDD a_741_93 a_843_236 VDD sg13_lv_pmos w=1120n l=130n ng=1 m=1
MN14 a_2002_114 RESET_B VSS VSS sg13_lv_nmos w=420n l=130n ng=1 m=1
MP15 VDD a_1583_191 a_2250_412 VDD sg13_lv_pmos w=1120n l=130n ng=1 m=1
MP16 Q a_2250_412 VDD VDD sg13_lv_pmos w=1120n l=130n ng=1 m=1
MN17 a_132_114 D a_38_114 VSS sg13_lv_nmos w=420n l=130n ng=1 m=1
MP18 a_1785_429 a_843_236 a_1583_191 VDD sg13_lv_pmos w=420n l=130n ng=1 m=1
MP19 VDD a_1583_191 a_1840_334 VDD sg13_lv_pmos w=420n l=130n ng=1 m=1
MP20 a_1583_191 a_741_93 a_324_432 VDD sg13_lv_pmos w=1u l=130n ng=1 m=1
MN21 a_1583_191 a_741_93 a_1489_191 VSS sg13_lv_nmos w=420n l=130n ng=1 m=1
MP22 VDD a_1840_334 a_1785_429 VDD sg13_lv_pmos w=420n l=130n ng=1 m=1
MP23 a_1840_334 RESET_B VDD VDD sg13_lv_pmos w=420n l=130n ng=1 m=1
MN24 a_324_432 a_843_236 a_1583_191 VSS sg13_lv_nmos w=740n l=130n ng=1 m=1
MN25 a_298_337 a_741_93 a_38_114 VSS sg13_lv_nmos w=420n l=130n ng=1 m=1
MN26 a_612_127 a_324_432 a_550_127 VSS sg13_lv_nmos w=420n l=130n ng=1 m=1
MP27 a_681_505 a_324_432 VDD VDD sg13_lv_pmos w=420n l=130n ng=1 m=1
MN28 a_612_127 a_843_236 a_298_337 VSS sg13_lv_nmos w=420n l=130n ng=1 m=1
MN29 VSS a_1583_191 a_2250_412 VSS sg13_lv_nmos w=740n l=130n ng=1 m=1
MP30 a_324_432 a_298_337 VDD VDD sg13_lv_pmos w=1u l=130n ng=1 m=1
MN31 Q a_2250_412 VSS VSS sg13_lv_nmos w=740n l=130n ng=1 m=1

.ends ctl_sg13g2_dfrbpq_1


**************************************************
* SUBCKT: ctl_sg13g2_nand4_1
**************************************************

.subckt ctl_sg13g2_nand4_1 VDD Y B C VSS A D

MN0 Y A a_350_122 VSS sg13_lv_nmos w=740n l=130n ng=1 m=1
MP1 Y D VDD VDD sg13_lv_pmos w=1120n l=130n ng=1 m=1
MP2 VDD C Y VDD sg13_lv_pmos w=1120n l=130n ng=1 m=1
MP3 Y B VDD VDD sg13_lv_pmos w=1120n l=130n ng=1 m=1
MP4 VDD A Y VDD sg13_lv_pmos w=1120n l=130n ng=1 m=1
MN5 a_146_122 D VSS VSS sg13_lv_nmos w=740n l=130n ng=1 m=1
MN6 a_248_122 C a_146_122 VSS sg13_lv_nmos w=740n l=130n ng=1 m=1
MN7 a_350_122 B a_248_122 VSS sg13_lv_nmos w=740n l=130n ng=1 m=1

.ends ctl_sg13g2_nand4_1


**************************************************
* SUBCKT: ctl_sg13g2_a221oi_1
**************************************************

.subckt ctl_sg13g2_a221oi_1 C1 Y B2 B1 A2 VDD A1 VSS

MN0 a_550_140 A1 Y VSS sg13_lv_nmos w=740n l=130n ng=1 m=1
MN1 VSS A2 a_550_140 VSS sg13_lv_nmos w=740n l=130n ng=1 m=1
MP2 a_142_412 C1 Y VDD sg13_lv_pmos w=1120n l=130n ng=1 m=1
MP3 a_244_412 B2 a_142_412 VDD sg13_lv_pmos w=1120n l=130n ng=1 m=1
MP4 a_142_412 B1 a_244_412 VDD sg13_lv_pmos w=1120n l=130n ng=1 m=1
MP5 a_244_412 A1 VDD VDD sg13_lv_pmos w=1120n l=130n ng=1 m=1
MP6 VDD A2 a_244_412 VDD sg13_lv_pmos w=1120n l=130n ng=1 m=1
MN7 VSS C1 Y VSS sg13_lv_nmos w=740n l=130n ng=1 m=1
MN8 a_244_140 B2 VSS VSS sg13_lv_nmos w=740n l=130n ng=1 m=1
MN9 Y B1 a_244_140 VSS sg13_lv_nmos w=740n l=130n ng=1 m=1

.ends ctl_sg13g2_a221oi_1


**************************************************
* SUBCKT: ctl_sg13g2_a21o_1
**************************************************

.subckt ctl_sg13g2_a21o_1 B1 X VDD VSS A1 A2

MN0 VSS a_115_308 X VSS sg13_lv_nmos w=740n l=130n ng=1 m=1
MP1 VDD A1 a_358_436 VDD sg13_lv_pmos w=1u l=130n ng=1 m=1
MN2 VSS A2 a_494_160 VSS sg13_lv_nmos w=640n l=130n ng=1 m=1
MP3 a_358_436 A2 VDD VDD sg13_lv_pmos w=1u l=130n ng=1 m=1
MN4 a_115_308 B1 VSS VSS sg13_lv_nmos w=640n l=130n ng=1 m=1
MN5 a_494_160 A1 a_115_308 VSS sg13_lv_nmos w=640n l=130n ng=1 m=1
MP6 a_358_436 B1 a_115_308 VDD sg13_lv_pmos w=1u l=130n ng=1 m=1
MP7 VDD a_115_308 X VDD sg13_lv_pmos w=1120n l=130n ng=1 m=1

.ends ctl_sg13g2_a21o_1


**************************************************
* SUBCKT: ctl_sg13g2_o21ai_1
**************************************************

.subckt ctl_sg13g2_o21ai_1 VSS VDD Y B1 A2 A1

MN0 VSS A1 a_22_110 VSS sg13_lv_nmos w=740n l=150n ng=1 m=1
MP1 a_120_432 A1 VDD VDD sg13_lv_pmos w=1120n l=150n ng=1 m=1
MN2 a_22_110 A2 VSS VSS sg13_lv_nmos w=740n l=150n ng=1 m=1
MN3 Y B1 a_22_110 VSS sg13_lv_nmos w=740n l=150n ng=1 m=1
MP4 Y A2 a_120_432 VDD sg13_lv_pmos w=1120n l=150n ng=1 m=1
MP5 VDD B1 Y VDD sg13_lv_pmos w=1120n l=150n ng=1 m=1

.ends ctl_sg13g2_o21ai_1


**************************************************
* SUBCKT: ctl_sg13g2_nor4_1
**************************************************

.subckt ctl_sg13g2_nor4_1 VSS VDD B C Y A D

MN0 Y C VSS VSS sg13_lv_nmos w=740n l=130n ng=1 m=1
MP1 a_252_412 B a_150_412 VDD sg13_lv_pmos w=1120n l=130n ng=1 m=1
MN2 VSS D Y VSS sg13_lv_nmos w=740n l=130n ng=1 m=1
MP3 a_354_412 C a_252_412 VDD sg13_lv_pmos w=1120n l=130n ng=1 m=1
MP4 Y D a_354_412 VDD sg13_lv_pmos w=1120n l=130n ng=1 m=1
MN5 Y A VSS VSS sg13_lv_nmos w=740n l=130n ng=1 m=1
MN6 VSS B Y VSS sg13_lv_nmos w=740n l=130n ng=1 m=1
MP7 a_150_412 A VDD VDD sg13_lv_pmos w=1120n l=130n ng=1 m=1

.ends ctl_sg13g2_nor4_1


**************************************************
* SUBCKT: ctl_sg13g2_decap_8
**************************************************

.subckt ctl_sg13g2_decap_8 VDD VSS

MP0 VDD VSS VDD VDD sg13_lv_pmos w=1u l=1u ng=1 m=1
MN1 VSS VDD VSS VSS sg13_lv_nmos w=420n l=1u ng=1 m=1
MP2 VDD VSS VDD VDD sg13_lv_pmos w=1u l=1u ng=1 m=1
MN3 VSS VDD VSS VSS sg13_lv_nmos w=420n l=1u ng=1 m=1

.ends ctl_sg13g2_decap_8


**************************************************
* SUBCKT: ctl_sg13g2_or2_1
**************************************************

.subckt ctl_sg13g2_or2_1 A VSS B X VDD

MP0 a_142_492 B a_48_492 VDD sg13_lv_pmos w=840n l=130n ng=1 m=1
MP1 VDD A a_142_492 VDD sg13_lv_pmos w=840n l=130n ng=1 m=1
MN2 X a_48_492 VSS VSS sg13_lv_nmos w=740n l=130n ng=1 m=1
MN3 VSS A a_48_492 VSS sg13_lv_nmos w=550n l=130n ng=1 m=1
MN4 a_48_492 B VSS VSS sg13_lv_nmos w=550n l=130n ng=1 m=1
MP5 X a_48_492 VDD VDD sg13_lv_pmos w=1120n l=130n ng=1 m=1

.ends ctl_sg13g2_or2_1


**************************************************
* SUBCKT: ctl_sg13g2_a22oi_1
**************************************************

.subckt ctl_sg13g2_a22oi_1 Y A2 VDD B1 A1 VSS B2

MN0 Y B2 a_127_96 VSS sg13_lv_nmos w=740n l=130n ng=1 m=1
MN1 a_398_96 A1 Y VSS sg13_lv_nmos w=740n l=130n ng=1 m=1
MP2 VDD A2 a_127_436 VDD sg13_lv_pmos w=1120n l=130n ng=1 m=1
MP3 Y B1 a_127_436 VDD sg13_lv_pmos w=1120n l=130n ng=1 m=1
MP4 a_127_436 B2 Y VDD sg13_lv_pmos w=1120n l=130n ng=1 m=1
MN5 a_127_96 B1 VSS VSS sg13_lv_nmos w=740n l=130n ng=1 m=1
MP6 a_127_436 A1 VDD VDD sg13_lv_pmos w=1120n l=130n ng=1 m=1
MN7 VSS A2 a_398_96 VSS sg13_lv_nmos w=740n l=130n ng=1 m=1

.ends ctl_sg13g2_a22oi_1


**************************************************
* SUBCKT: ctl_sg13g2_a21oi_1
**************************************************

.subckt ctl_sg13g2_a21oi_1 VDD VSS A2 A1 B1 Y

MN0 Y B1 VSS VSS sg13_lv_nmos w=740n l=130n ng=1 m=1
MN1 a_257_140 A1 Y VSS sg13_lv_nmos w=740n l=130n ng=1 m=1
MN2 VSS A2 a_257_140 VSS sg13_lv_nmos w=740n l=130n ng=1 m=1
MP3 a_155_412 B1 Y VDD sg13_lv_pmos w=1120n l=130n ng=1 m=1
MP4 VDD A1 a_155_412 VDD sg13_lv_pmos w=1120n l=130n ng=1 m=1
MP5 a_155_412 A2 VDD VDD sg13_lv_pmos w=1120n l=130n ng=1 m=1

.ends ctl_sg13g2_a21oi_1


**************************************************
* SUBCKT: ctl_sg13g2_decap_4
**************************************************

.subckt ctl_sg13g2_decap_4 VDD VSS

MP0 VDD VSS VDD VDD sg13_lv_pmos w=1u l=1u ng=1 m=1
MN1 VSS VDD VSS VSS sg13_lv_nmos w=420n l=1u ng=1 m=1

.ends ctl_sg13g2_decap_4


**************************************************
* SUBCKT: ctl_sg13g2_nor3_1
**************************************************

.subckt ctl_sg13g2_nor3_1 A Y B C VDD VSS
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
