EduHolg/IHP__SoC6169/SoC6169-main/verification/netgen/xschem_vs_spice_netgen/COMPLETE_PROYECT_FIG_xschem_lvs.spice

** sch_path: schematic/COMPLETE_PROYECT_FIG.sch
.subckt COMPLETE_PROYECT_FIG CLK EN_REFERENCE EN_SEARCH EN_WRITE OUTPUT VDD VEVAL_IN VSS reset
+ serial_in_addr serial_in_data
*.PININFO CLK:I EN_REFERENCE:I EN_SEARCH:I EN_WRITE:I OUTPUT:O VDD:B VEVAL_IN:B VSS:B reset:I
*+ serial_in_addr:I serial_in_data:I
XahdlI18 EN_REFERENCE EN_SEARCH EN_WRITE PC VEVAL1 CLK OUTPUT_en reset REF_sel wl_ref addr_shift
+ deco_en shift_en VSS VDD CAM_CONTROL
XahdlI15 REF_sel net48 net137 net135 net133 net131 net129 net127 net125 net123 net121 net119 net46
+ net117 net115 net113 net111 net109 net107 net105 net103 net101 net99 net44 net97 net96 net42 net40 net33
+ net30 net27 net23 net4 RS0 net3 net136 net134 net132 net130 RS15 RS16 net124 net122 net120 RS1 net118
+ net116 net114 net112 net110 net108 net106 net104 net102 net100 RS2 net98 RS31 net43 net41 net34 net31
+ net29 net25 net22 q0n q10n q11n q12n q13n q14n q15n q16n q17n q18n q19n q1n q20n q21n q22n q23n q24n q25n
+ q26n q27n q28n q29n q2n q30n q31n q3n q4n q5n q6n q7n q8n q9n q0 q10 q11 q12 q13 q14 q15 q16 q17 q18 q19
+ q1 q20 q21 q22 q23 q24 q25 q26 q27 q28 q29 q2 q30 q31 q3 q4 q5 q6 q7 q8 q9 VSS VDD REFERENCE_MUX
XahdlI13 VSS VDD deco_en add0 add1 add2 add3 add4 out0 out10 out11 out12 out13 out14 out15 out16
+ out17 out18 out19 out1 out20 out21 out22 out23 out24 out25 out26 out27 out28 out29 out2 out30 out31 out3
+ out4 out5 out6 out7 out8 out9 decoder_5to32
XahdlI14 VSS VDD CLK q0 q10 q11 q12 q13 q14 q15 q16 q17 q18 q19 q1 q20 q21 q22 q23 q24 q25 q26 q27
+ q28 q29 q2 q30 q31 q3 q4 q5 q6 q7 q8 q9 q0n q10n q11n q12n q13n q14n q15n q16n q17n q18n q19n q1n q20n
+ q21n q22n q23n q24n q25n q26n q27n q28n q29n q2n q30n q31n q3n q4n q5n q6n q7n q8n q9n reset
+ serial_in_data_int shift_en shift_register_32
XI21 serial_in_data REF_sel serial_in_data_int VDD VSS Xnor
XahdlI16 VSS VDD CLK COMP0 net154 net153 net152 COMP13 net150 net149 net148 net147 net146 net145
+ net163 COMP20 net143 COMP22 net141 net140 net139 net138 net128 net126 net92 net162 net90 COMP31 net161
+ net160 COMP5 net158 net157 net156 net155 OUTPUT OUTPUT_en reset OUTPUT
XI20 COMP0 net163 net154 net153 net152 COMP13 net150 net149 net148 net147 net146 net145 net162
+ COMP20 net143 COMP22 net141 net140 net139 net138 net128 net126 net92 net161 net90 COMP31 net160 COMP5
+ net158 net157 net156 net155 PC RS0 net48 RS1 net3 net137 net136 net135 net134 net133 net132 net131 net130
+ net129 RS15 net127 RS16 net125 net124 net123 net122 net121 net120 net119 net46 RS2 net118 net117 net116
+ net115 net114 net113 net112 net111 net110 net109 net108 net107 net106 net105 net104 net103 net102 net101
+ net100 net99 net44 net43 net98 net97 RS31 net96 net42 net41 net40 net34 net33 net31 net30 net29 net27
+ net25 net23 net22 net4 q0 q0n q1 q10 q10n q11 q11n q12 q12n q13 q13n q14 q14n q15 q15n q16 q16n q17 q17n
+ q18 q18n q19 q19n q1n q2 q20 q20n q21 q21n q22 q22n q23 q23n q24 q24n q25 q25n q26 q26n q27 q27n q28
+ q28n q29 q29n q2n q3 q30 q30n q31 q31n q3n q4 q4n q5 q5n q6 q6n q7 q7n q8 q8n q9 q9n VDD VEVAL VSS
+ wl_ref out0 out1 out10 out11 out12 out13 out14 out15 out16 out17 out18 out19 out2 out20 out21 out22 out23
+ out24 out25 out26 out27 out28 out29 out3 out30 out31 out4 out5 out6 out7 out8 out9 ANALOG_FIGURE
XahdlI12 VSS VDD add0 add1 add2 add3 add4 addr_shift CLK reset serial_in_addr SHIFT_5
MN0 VEVAL VEVAL1 VSS VSS sg13_lv_nmos w=500n l=130n ng=1 m=1
MP0 VEVAL VEVAL1 VEVAL_IN VEVAL_IN sg13_lv_pmos w=15u l=130n ng=1 m=1
.ends

* expanding   symbol:  CAM_CONTROL.sym # of pins=15
** sym_path: schematic/CAM_CONTROL.sym
** sch_path: schematic/CAM_CONTROL.sch
.subckt CAM_CONTROL EN_REFERENCE EN_SEARCH EN_WRITE PC VEVAL clk output_enable reset REF_SEL WL_REF
+ addr_shift_enable decoder_enable shift_enable VGND VPWR
*.PININFO EN_REFERENCE:I EN_SEARCH:I EN_WRITE:I PC:O VEVAL:O clk:I output_enable:O reset:I REF_SEL:O
*+ WL_REF:O addr_shift_enable:O decoder_enable:O shift_enable:O VGND:B VPWR:B
Xctl_sg13g2_and2_1_3 ctl_sg13g2_and2_1_3_X ctl_sg13g2_nor3_1_4_A ctl_sg13g2_and2_1_3_B VPWR VGND
+ sg13cmos5l_and2_1
Xctl_sg13g2_nand2b_1_0 ctl_sg13g2_nand2_1_4_A ctl_sg13g2_nor3_1_3_B ctl_sg13g2_nor2_1_10_B VPWR VGND
+ sg13cmos5l_nand2b_1
Xctl_sg13g2_inv_1_1 ctl_sg13g2_inv_1_1_Y ctl_sg13g2_inv_1_6_A VPWR VGND sg13cmos5l_inv_1
Xctl_sg13g2_buf_1_1 decoder_enable ctl_sg13g2_buf_1_1_A VPWR VGND sg13cmos5l_buf_1
Xctl_sg13g2_dlygate4sd3_1_14 ctl_sg13g2_nor4_1_0_A ctl_sg13g2_nor3_1_0_Y VPWR VGND
+ sg13cmos5l_dlygate4sd3_1
Xctl_sg13g2_nor2_1_5 ctl_sg13g2_nor4_1_0_D ctl_sg13g2_nor2_1_5_A ctl_sg13g2_nor3_1_0_A VPWR VGND
+ sg13cmos5l_nor2_1
Xctl_sg13g2_dfrbpq_1_9 ctl_sg13g2_buf_1_5_A clk ctl_sg13g2_nor4_1_0_Y ctl_sg13g2_inv_1_17_Y VPWR
+ VGND sg13cmos5l_dfrbpq_1
Xctl_sg13g2_and2_1_4 ctl_sg13g2_nor3_1_0_B ctl_sg13g2_or2_1_0_A ctl_sg13g2_or2_1_0_B VPWR VGND
+ sg13cmos5l_and2_1
Xctl_sg13g2_nand4_1_0 ctl_sg13g2_nand4_1_0_Y ctl_sg13g2_inv_1_0_A ctl_sg13g2_nor3_1_6_B
+ ctl_sg13g2_nor2_1_2_A ctl_sg13g2_nor3_1_6_C VPWR VGND sg13cmos5l_nand4_1
Xctl_sg13g2_nand2b_1_1 ctl_sg13g2_nor2_1_10_B ctl_sg13g2_xor2_1_1_B ctl_sg13g2_and2_1_2_B VPWR VGND
+ sg13cmos5l_nand2b_1
Xctl_sg13g2_inv_1_2 ctl_sg13g2_inv_1_2_Y ctl_sg13g2_inv_1_6_A VPWR VGND sg13cmos5l_inv_1
Xctl_sg13g2_buf_1_2 VEVAL ctl_sg13g2_buf_1_2_A VPWR VGND sg13cmos5l_buf_1
Xctl_sg13g2_buf_1_10 ctl_sg13g2_buf_1_10_X EN_WRITE VPWR VGND sg13cmos5l_buf_1
Xctl_sg13g2_nor2_1_6 ctl_sg13g2_nor2_1_6_Y ctl_sg13g2_nor2_1_7_A ctl_sg13g2_nor3_1_3_B VPWR VGND
+ sg13cmos5l_nor2_1
Xctl_sg13g2_dlygate4sd3_1_15 ctl_sg13g2_xor2_1_0_A ctl_sg13g2_or2_1_0_A VPWR VGND
+ sg13cmos5l_dlygate4sd3_1
Xctl_sg13g2_nand2b_1_2 ctl_sg13g2_nand2_1_3_A ctl_sg13g2_o21ai_1_7_A1 ctl_sg13g2_buf_1_10_X VPWR
+ VGND sg13cmos5l_nand2b_1
Xctl_sg13g2_a221oi_1_0 ctl_sg13g2_o21ai_1_4_A2 ctl_sg13g2_inv_1_27_Y ctl_sg13g2_mux2_1_1_X
+ ctl_sg13g2_nor3_1_2_A ctl_sg13g2_nor3_1_1_B ctl_sg13g2_and2_1_3_X VPWR VGND sg13cmos5l_a221oi_1
Xctl_sg13g2_buf_1_3 shift_enable ctl_sg13g2_buf_1_3_A VPWR VGND sg13cmos5l_buf_1
Xctl_sg13g2_buf_1_11 REF_SEL ctl_sg13g2_buf_1_11_A VPWR VGND sg13cmos5l_buf_1
Xctl_sg13g2_inv_1_3 ctl_sg13g2_inv_1_3_Y ctl_sg13g2_inv_1_6_A VPWR VGND sg13cmos5l_inv_1
Xctl_sg13g2_a21o_1_0 ctl_sg13g2_a21o_1_0_X ctl_sg13g2_inv_1_0_A ctl_sg13g2_nor3_1_6_B
+ ctl_sg13g2_nor3_1_6_C VPWR VGND sg13cmos5l_a21o_1
Xctl_sg13g2_nor2_1_7 ctl_sg13g2_nor3_1_3_C ctl_sg13g2_nor2_1_7_A ctl_sg13g2_nor3_1_1_A VPWR VGND
+ sg13cmos5l_nor2_1
Xctl_sg13g2_nand2b_1_3 ctl_sg13g2_nand2b_1_5_B ctl_sg13g2_a21oi_1_3_B1 ctl_sg13g2_buf_1_9_X VPWR
+ VGND sg13cmos5l_nand2b_1
Xctl_sg13g2_buf_1_4 output_enable ctl_sg13g2_buf_1_4_A VPWR VGND sg13cmos5l_buf_1
Xctl_sg13g2_buf_1_12 ctl_sg13g2_buf_1_12_X EN_SEARCH VPWR VGND sg13cmos5l_buf_1
Xctl_sg13g2_inv_1_4 ctl_sg13g2_inv_1_4_Y ctl_sg13g2_inv_1_4_A VPWR VGND sg13cmos5l_inv_1
Xctl_sg13g2_a21o_1_1 ctl_sg13g2_a21o_1_1_X ctl_sg13g2_a21o_1_1_A1 ctl_sg13g2_buf_1_12_X
+ ctl_sg13g2_nor2_1_9_Y VPWR VGND sg13cmos5l_a21o_1
Xctl_sg13g2_nor2_1_8 ctl_sg13g2_inv_1_0_A ctl_sg13g2_nor2_1_9_Y ctl_sg13g2_nor2_1_8_B VPWR VGND
+ sg13cmos5l_nor2_1
Xctl_sg13g2_nand2b_1_4 ctl_sg13g2_nand2b_1_4_Y ctl_sg13g2_a21o_1_1_A1 ctl_sg13g2_buf_1_12_X VPWR
+ VGND sg13cmos5l_nand2b_1
Xctl_sg13g2_buf_1_5 addr_shift_enable ctl_sg13g2_buf_1_5_A VPWR VGND sg13cmos5l_buf_1
Xctl_sg13g2_inv_1_5 ctl_sg13g2_inv_1_5_Y ctl_sg13g2_inv_1_6_A VPWR VGND sg13cmos5l_inv_1
Xctl_sg13g2_buf_1_13 ctl_sg13g2_inv_1_6_A ctl_sg13g2_buf_1_8_A VPWR VGND sg13cmos5l_buf_1
Xctl_sg13g2_a21o_1_2 ctl_sg13g2_buf_1_15_A ctl_sg13g2_or2_1_0_X ctl_sg13g2_nor3_1_0_A
+ ctl_sg13g2_nor3_1_0_B VPWR VGND sg13cmos5l_a21o_1
Xctl_sg13g2_nor2_1_9 ctl_sg13g2_nor2_1_9_Y ctl_sg13g2_nor2_1_9_A ctl_sg13g2_nor2_1_9_B VPWR VGND
+ sg13cmos5l_nor2_1
Xctl_sg13g2_nand2b_1_5 ctl_sg13g2_nor2_1_9_B ctl_sg13g2_nand2b_1_4_Y ctl_sg13g2_nand2b_1_5_B VPWR
+ VGND sg13cmos5l_nand2b_1
Xctl_sg13g2_buf_1_6 ctl_sg13g2_buf_1_7_A reset VPWR VGND sg13cmos5l_buf_1
Xctl_sg13g2_inv_1_6 ctl_sg13g2_inv_1_6_Y ctl_sg13g2_inv_1_6_A VPWR VGND sg13cmos5l_inv_1
Xctl_sg13g2_buf_1_14 ctl_sg13g2_xor2_1_1_A ctl_sg13g2_buf_1_14_A VPWR VGND sg13cmos5l_buf_1
Xctl_sg13g2_a21o_1_3 ctl_sg13g2_or2_1_0_B ctl_sg13g2_inv_1_27_Y ctl_sg13g2_mux2_1_1_X
+ ctl_sg13g2_and2_1_3_X VPWR VGND sg13cmos5l_a21o_1
Xctl_sg13g2_nand2b_1_6 ctl_sg13g2_mux2_1_1_A0 ctl_sg13g2_xor2_1_1_A ctl_sg13g2_xor2_1_1_B VPWR VGND
+ sg13cmos5l_nand2b_1
Xctl_sg13g2_buf_1_7 ctl_sg13g2_buf_1_8_A ctl_sg13g2_buf_1_7_A VPWR VGND sg13cmos5l_buf_1
Xctl_sg13g2_inv_1_7 ctl_sg13g2_inv_1_7_Y ctl_sg13g2_inv_1_9_A VPWR VGND sg13cmos5l_inv_1
Xctl_sg13g2_buf_1_15 ctl_sg13g2_nor3_1_3_B ctl_sg13g2_buf_1_15_A VPWR VGND sg13cmos5l_buf_1
Xctl_sg13g2_buf_1_8 ctl_sg13g2_inv_1_9_A ctl_sg13g2_buf_1_8_A VPWR VGND sg13cmos5l_buf_1
Xctl_sg13g2_buf_1_16 WL_REF ctl_sg13g2_buf_1_16_A VPWR VGND sg13cmos5l_buf_1
Xctl_sg13g2_inv_1_8 ctl_sg13g2_inv_1_8_Y ctl_sg13g2_inv_1_9_A VPWR VGND sg13cmos5l_inv_1
Xctl_sg13g2_dlygate4sd3_1_0 ctl_sg13g2_nor3_1_6_C ctl_sg13g2_a21oi_1_1_Y VPWR VGND
+ sg13cmos5l_dlygate4sd3_1
Xctl_sg13g2_o21ai_1_0 ctl_sg13g2_o21ai_1_0_Y ctl_sg13g2_nor3_1_4_A ctl_sg13g2_buf_1_14_A
+ ctl_sg13g2_buf_1_15_A VPWR VGND sg13cmos5l_o21ai_1
Xctl_sg13g2_buf_1_9 ctl_sg13g2_buf_1_9_X EN_REFERENCE VPWR VGND sg13cmos5l_buf_1
Xctl_sg13g2_inv_1_9 ctl_sg13g2_inv_1_9_Y ctl_sg13g2_inv_1_9_A VPWR VGND sg13cmos5l_inv_1
Xctl_sg13g2_nor2_1_10 ctl_sg13g2_nor2_1_10_Y ctl_sg13g2_nor3_1_4_Y ctl_sg13g2_nor2_1_10_B VPWR VGND
+ sg13cmos5l_nor2_1
Xctl_sg13g2_dlygate4sd3_1_1 ctl_sg13g2_o21ai_1_6_A1 ctl_sg13g2_nor3_1_4_A VPWR VGND
+ sg13cmos5l_dlygate4sd3_1
Xctl_sg13g2_o21ai_1_1 ctl_sg13g2_o21ai_1_1_Y ctl_sg13g2_nor3_1_6_C ctl_sg13g2_nor3_1_5_C
+ ctl_sg13g2_nor2_1_2_A VPWR VGND sg13cmos5l_o21ai_1
Xctl_sg13g2_nor4_1_0 ctl_sg13g2_nor4_1_0_Y ctl_sg13g2_nor4_1_0_A ctl_sg13g2_nor4_1_0_B
+ ctl_sg13g2_nor4_1_0_C ctl_sg13g2_nor4_1_0_D VPWR VGND sg13cmos5l_nor4_1
Xctl_sg13g2_dlygate4sd3_1_2 ctl_sg13g2_a21oi_1_1_A1 ctl_sg13g2_nor3_1_4_B VPWR VGND
+ sg13cmos5l_dlygate4sd3_1
Xctl_sg13g2_o21ai_1_2 ctl_sg13g2_o21ai_1_2_Y ctl_sg13g2_inv_1_27_Y ctl_sg13g2_inv_1_25_Y
+ ctl_sg13g2_and2_1_3_B VPWR VGND sg13cmos5l_o21ai_1
Xctl_sg13g2_dlygate4sd3_1_3 ctl_sg13g2_nor4_1_0_C ctl_sg13g2_nand4_1_0_Y VPWR VGND
+ sg13cmos5l_dlygate4sd3_1
Xctl_sg13g2_o21ai_1_3 ctl_sg13g2_o21ai_1_3_Y ctl_sg13g2_nor2_1_1_Y ctl_sg13g2_a21o_1_0_X
+ ctl_sg13g2_nor4_1_0_C VPWR VGND sg13cmos5l_o21ai_1
Xctl_sg13g2_dlygate4sd3_1_4 ctl_sg13g2_nor3_1_1_A ctl_sg13g2_dfrbpq_1_17_Q VPWR VGND
+ sg13cmos5l_dlygate4sd3_1
Xctl_sg13g2_o21ai_1_4 ctl_sg13g2_nor3_1_0_A ctl_sg13g2_nor3_1_1_Y ctl_sg13g2_o21ai_1_4_A2
+ ctl_sg13g2_a21oi_1_2_Y VPWR VGND sg13cmos5l_o21ai_1
Xctl_sg13g2_dlygate4sd3_1_5 ctl_sg13g2_nor3_1_1_B ctl_sg13g2_dfrbpq_1_8_Q VPWR VGND
+ sg13cmos5l_dlygate4sd3_1
Xctl_sg13g2_o21ai_1_5 ctl_sg13g2_and2_1_2_B ctl_sg13g2_nor3_1_4_A ctl_sg13g2_xor2_1_1_A
+ ctl_sg13g2_nor3_1_4_B VPWR VGND sg13cmos5l_o21ai_1
Xctl_sg13g2_dlygate4sd3_1_6 ctl_sg13g2_nor2_1_7_A ctl_sg13g2_dfrbpq_1_11_Q VPWR VGND
+ sg13cmos5l_dlygate4sd3_1
Xctl_sg13g2_o21ai_1_6 ctl_sg13g2_nor2_1_2_A ctl_sg13g2_o21ai_1_6_A1 ctl_sg13g2_and3_1_1_X
+ ctl_sg13g2_nand2_1_5_Y VPWR VGND sg13cmos5l_o21ai_1
Xctl_sg13g2_decap_8_0 VPWR VGND sg13cmos5l_decap_8
Xctl_sg13g2_or2_1_0 ctl_sg13g2_or2_1_0_X ctl_sg13g2_or2_1_0_A ctl_sg13g2_or2_1_0_B VPWR VGND
+ sg13cmos5l_or2_1
Xctl_sg13g2_dlygate4sd3_1_7 ctl_sg13g2_nor3_1_1_C ctl_sg13g2_dfrbpq_1_10_Q VPWR VGND
+ sg13cmos5l_dlygate4sd3_1
Xctl_sg13g2_o21ai_1_7 ctl_sg13g2_o21ai_1_7_Y ctl_sg13g2_o21ai_1_7_A1 ctl_sg13g2_nor2b_1_0_Y
+ ctl_sg13g2_buf_1_10_X VPWR VGND sg13cmos5l_o21ai_1
Xctl_sg13g2_decap_8_1 VPWR VGND sg13cmos5l_decap_8
Xctl_sg13g2_dlygate4sd3_1_8 ctl_sg13g2_o21ai_1_7_A1 ctl_sg13g2_dfrbpq_1_16_Q VPWR VGND
+ sg13cmos5l_dlygate4sd3_1
Xctl_sg13g2_a22oi_1_0 ctl_sg13g2_nand2_1_4_B ctl_sg13g2_nor3_1_3_B ctl_sg13g2_nor2_1_10_Y
+ ctl_sg13g2_nand2_1_3_Y ctl_sg13g2_nor2b_1_0_Y VPWR VGND sg13cmos5l_a22oi_1
Xctl_sg13g2_decap_8_2 VPWR VGND sg13cmos5l_decap_8
Xctl_sg13g2_dlygate4sd3_1_9 ctl_sg13g2_nor2b_1_1_A ctl_sg13g2_a21oi_1_3_Y VPWR VGND
+ sg13cmos5l_dlygate4sd3_1
Xctl_sg13g2_decap_8_3 VPWR VGND sg13cmos5l_decap_8
Xctl_sg13g2_a21oi_1_0 ctl_sg13g2_a21oi_1_0_Y ctl_sg13g2_inv_1_0_A ctl_sg13g2_nor3_1_6_B
+ ctl_sg13g2_nor2_1_2_A VPWR VGND sg13cmos5l_a21oi_1
Xctl_sg13g2_decap_8_4 VPWR VGND sg13cmos5l_decap_8
Xctl_sg13g2_a21oi_1_1 ctl_sg13g2_a21oi_1_1_Y ctl_sg13g2_a21oi_1_1_A1 ctl_sg13g2_o21ai_1_0_Y
+ ctl_sg13g2_a21oi_1_4_Y VPWR VGND sg13cmos5l_a21oi_1
Xctl_sg13g2_decap_8_5 VPWR VGND sg13cmos5l_decap_8
Xctl_sg13g2_a21oi_1_2 ctl_sg13g2_a21oi_1_2_Y ctl_sg13g2_inv_1_27_Y ctl_sg13g2_mux2_1_1_X
+ ctl_sg13g2_a21oi_1_5_Y VPWR VGND sg13cmos5l_a21oi_1
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
