EduHolg/IHP__SoC6169/SoC6169-main/librelane/chip_top/src/chip_top.sv

// SPDX-FileCopyrightText: © 2025 LibreLane Template Contributors
// Modified for the CAM chip (IMNE-USFQ): 5 inputs + clk + reset, 1 output, 1 analog (VEVAL_IN)
// SPDX-License-Identifier: Apache-2.0

`default_nettype none

module chip_top #(
    // Power/ground pads for core
    parameter NUM_VDD_PADS = 3,
    parameter NUM_VSS_PADS = 2,
    
    // Power/ground pads for I/O
    parameter NUM_IOVDD_PADS = 3,
    parameter NUM_IOVSS_PADS = 2,
    
    // Signal pads
    parameter NUM_INPUT_PADS  = 5,
    parameter NUM_OUTPUT_PADS = 1,
    parameter NUM_ANALOG_PADS = 1
    )(
    `ifdef USE_POWER_PINS
    inout wire IOVDD,
    inout wire IOVSS,
    inout wire VDD,
    inout wire VSS,
    `endif
    inout  wire clk_PAD,
    inout  wire rst_n_PAD,
    inout  wire [NUM_INPUT_PADS-1 :0] input_PAD,
    inout  wire [NUM_OUTPUT_PADS-1:0] output_PAD,
    inout  wire [NUM_ANALOG_PADS-1:0] analog_PAD
);

    wire clk_PAD2CORE;
    wire rst_n_PAD2CORE;
    wire [NUM_INPUT_PADS-1 :0] input_PAD2CORE;
    wire [NUM_OUTPUT_PADS-1:0] output_CORE2PAD;
    wire [NUM_ANALOG_PADS-1:0] analog_PADRES;

    // Power/ground pad instances
    generate
    for (genvar i=0; i<NUM_IOVDD_PADS; i++) begin : iovdd_pads
        (* keep *)
        sg13cmos5l_IOPadIOVdd iovdd_pad  (
            `ifdef USE_POWER_PINS
            .iovdd  (IOVDD),
            .iovss  (IOVSS),
            .vdd    (VDD),
            .vss    (VSS)
            `endif
        );
    end
    for (genvar i=0; i<NUM_IOVSS_PADS; i++) begin : iovss_pads
        (* keep *)
        sg13cmos5l_IOPadIOVss iovss_pad  (
            `ifdef USE_POWER_PINS
            .iovdd  (IOVDD),
            .iovss  (IOVSS),
            .vdd    (VDD),
            .vss    (VSS)
            `endif
        );
    end
    for (genvar i=0; i<NUM_VDD_PADS; i++) begin : vdd_pads
        (* keep *)
        sg13cmos5l_IOPadVdd vdd_pad  (
            `ifdef USE_POWER_PINS
            .iovdd  (IOVDD),
            .iovss  (IOVSS),
            .vdd    (VDD),
            .vss    (VSS)
            `endif
        );
    end
    for (genvar i=0; i<NUM_VSS_PADS; i++) begin : vss_pads
        (* keep *)
        sg13cmos5l_IOPadVss vss_pad  (
            `ifdef USE_POWER_PINS
            .iovdd  (IOVDD),
            .iovss  (IOVSS),
            .vdd    (VDD),
            .vss    (VSS)
            `endif
        );
    end
    endgenerate

    // Signal IO pad instances

    sg13cmos5l_IOPadIn clk_pad (
        `ifdef USE_POWER_PINS
        .iovdd  (IOVDD),
        .iovss  (IOVSS),
        .vdd    (VDD),
        .vss    (VSS),
        `endif
        .p2c    (clk_PAD2CORE),
        .pad    (clk_PAD)
    );
    
    // Normal input
    sg13cmos5l_IOPadIn rst_n_pad (
        `ifdef USE_POWER_PINS
        .iovdd  (IOVDD),
        .iovss  (IOVSS),
        .vdd    (VDD),
        .vss    (VSS),
        `endif
        .p2c    (rst_n_PAD2CORE),
        .pad    (rst_n_PAD)
    );

    generate
    for (genvar i=0; i<NUM_INPUT_PADS; i++) begin : inputs
        sg13cmos5l_IOPadIn input_pad (
            `ifdef USE_POWER_PINS
            .iovdd  (IOVDD),
            .iovss  (IOVSS),
            .vdd    (VDD),
            .vss    (VSS),
            `endif
            .p2c    (input_PAD2CORE[i]),
            .pad    (input_PAD[i])
        );
    end
    endgenerate

    generate
    for (genvar i=0; i<NUM_OUTPUT_PADS; i++) begin : outputs
        sg13cmos5l_IOPadOut30mA output_pad (
            `ifdef USE_POWER_PINS
            .iovdd  (IOVDD),
            .iovss  (IOVSS),
            .vdd    (VDD),
            .vss    (VSS),
            `endif
            .c2p    (output_CORE2PAD[i]),
            .pad    (output_PAD[i])
        );
    end
    endgenerate

    
    generate
    for (genvar i=0; i<NUM_ANALOG_PADS; i++) begin : analogs
        (* keep *)
        sg13cmos5l_IOPadAnalog analog_pad (
            `ifdef USE_POWER_PINS
            .iovdd  (IOVDD),
            .iovss  (IOVSS),
            .vdd    (VDD),
            .vss    (VSS),
            `endif
            .padres (analog_PADRES[i]),
            .pad    (analog_PAD[i])
        );
    end
    endgenerate

    // Core design

    (* keep *) chip_core #(
        .NUM_INPUT_PADS  (NUM_INPUT_PADS),
        .NUM_OUTPUT_PADS (NUM_OUTPUT_PADS),
        .NUM_ANALOG_PADS (NUM_ANALOG_PADS)
    ) i_chip_core (
        .clk        (clk_PAD2CORE),
        .rst_n      (rst_n_PAD2CORE),
        .input_in   (input_PAD2CORE),
        .output_out (output_CORE2PAD),
        .analog     (analog_PADRES)
    );

endmodule

`default_nettype wire
