EduHolg/IHP__SoC6169/SoC6169-main/librelane/decoder_5to32/src/decoder_5to32.v

module decoder_5to32 (

    input  logic        decoder_enable,
    input  logic [4:0]  in,

    output logic [31:0] out
);

    always_comb begin

        out = 32'b0;

        if (decoder_enable)
            out[in] = 1'b1;

    end

endmodule
